oma-git/SwimForce/pictures/IMG_0896.jpeg

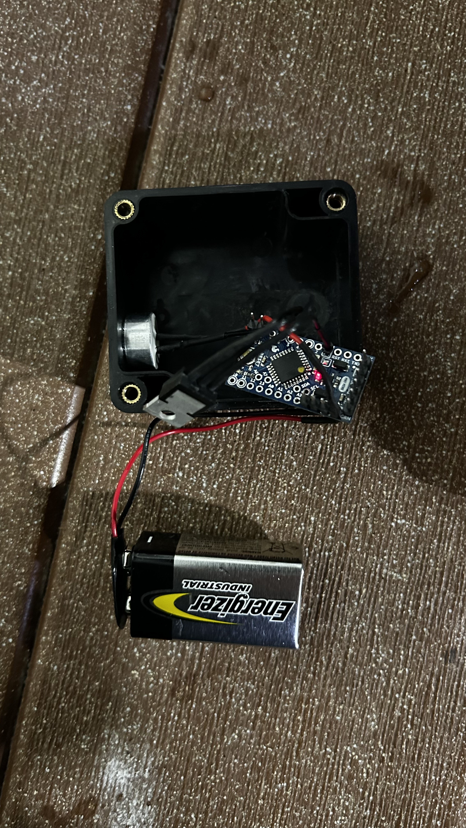
pictures/IMG_0896.jpeg
