oma-git/SwimForce/pictures/IMG_0898.jpeg

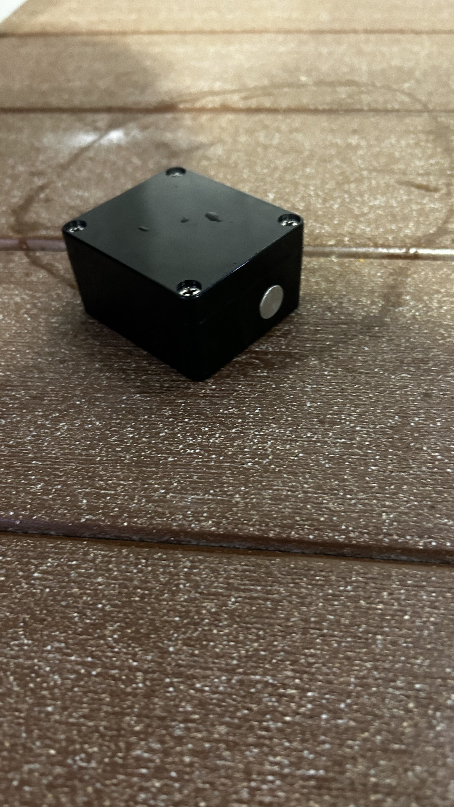
pictures/IMG_0898.jpeg
