oma-git/SwimForce/docs/SwimForce.pdf

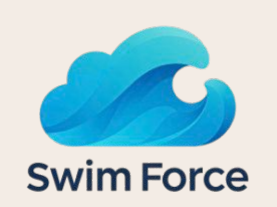
[picture p18: figure]

# A Comprehensive Swimmer Tracking System

# Cole Griscavage & Omar Ebied Professor Zucker

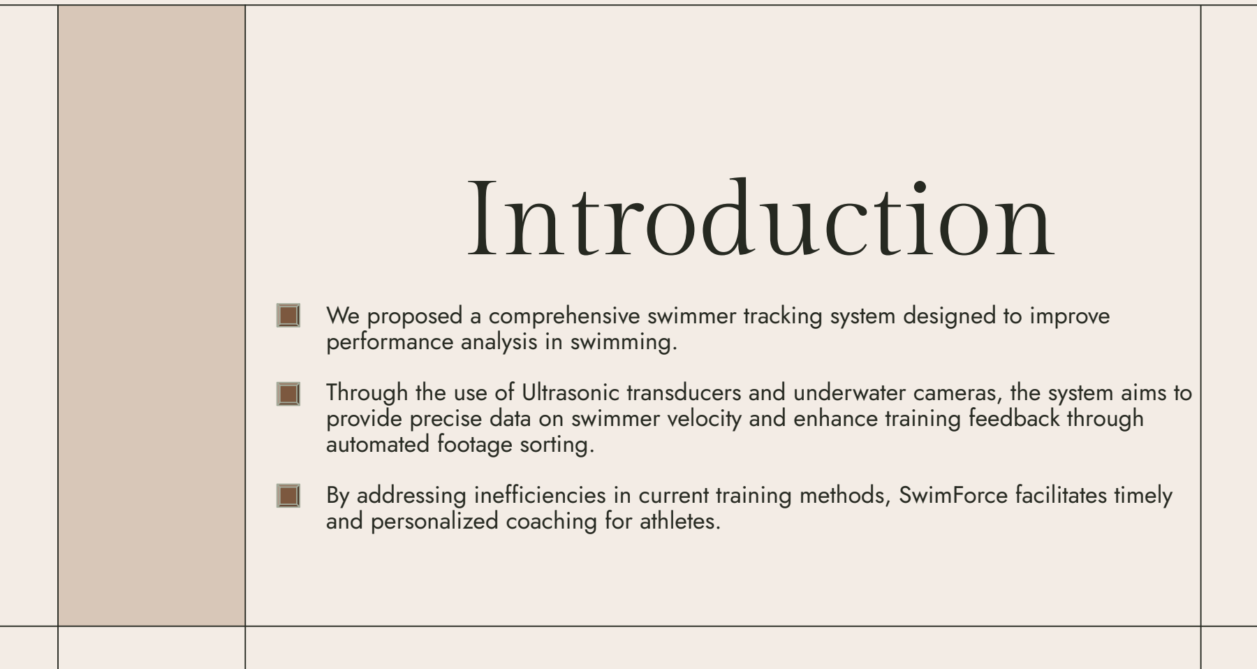
[picture p19: figure]
Introduction; performance analysis in swimming.; automated footage sorting.; and personalized coaching for athletes.

# - We proposed a comprehensive swimmer tracking system designed to improve

# - Through the use of Ultrasonic transducers and underwater cameras, the system aims to provide precise data on swimmer velocity and enhance training feedback through

# - By addressing inefficiencies in current training methods, SwimForce facilitates timely

# Goals & Overview

01

# Build ultrasonic transducer to emit customizable frequencies

# Waterproof the device & test with hydrophone in pool environment

# Use PoE cameras to capture clear footage look up from the bottom of the pool

# Write program to use hydrophone data to detect when a swimmer comes in range

# Edit program to sync camera input with hydrophone input to capture clips

# Use OpenCV to calculate swimmer velocity in acquired clips

# Edit program to collect and sort clips & data by athlete name

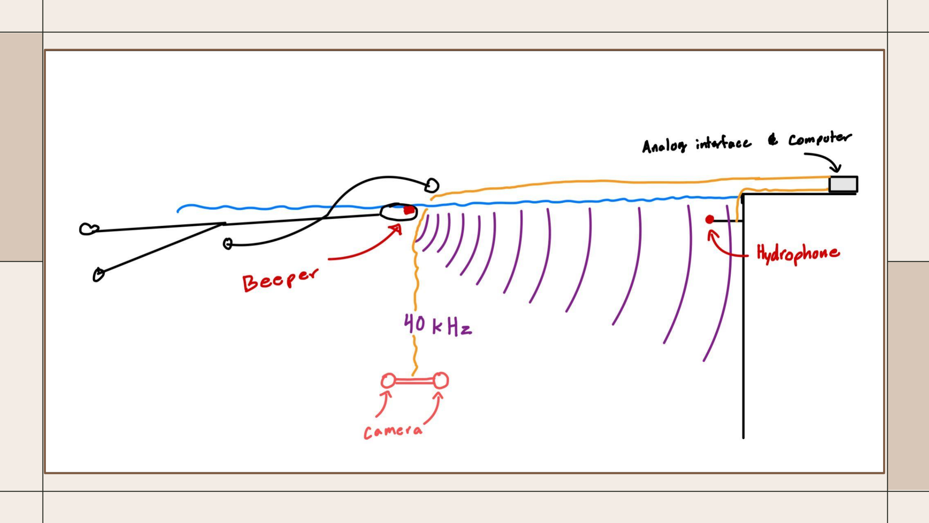
[picture p20: page 5]

# Build ultrasonic transducer to emit customizable frequencies

# Waterproof the device & test with hydrophone in pool environment

# Use PoE cameras to capture clear footage look up from the bottom of the pool

# Write program to use hydrophone data to detect when a swimmer comes in range

# Edit program to sync camera input with hydrophone input to capture clips

# Use OpenCV to calculate swimmer velocity in acquired clips

# Edit program to collect and sort clips & data by athlete name

# Timeline

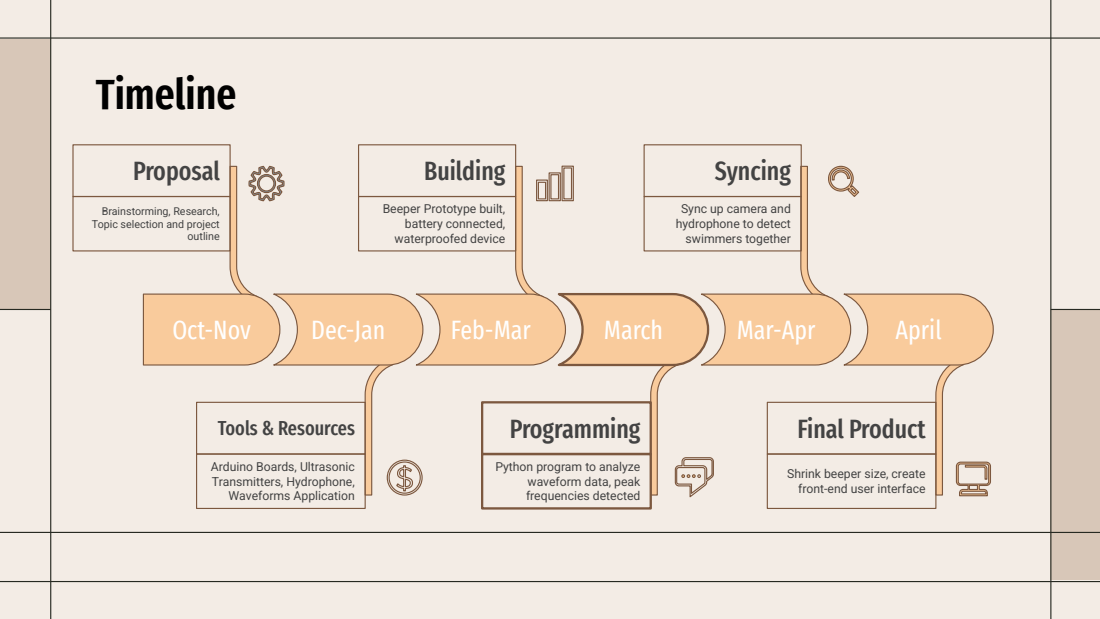
[picture p21: page 7]
Feb-Mar; Building; Mar-Apr; Syncing; Dec-Jan; Tools & Resources; March; Programming; April; Final Product; Oct-Nov; outline; Proposal

Brainstorming, Research,
Topic selection and project

Beeper Prototype built,
battery connected,
waterproofed device

Sync up camera and
hydrophone to detect
swimmers together

Arduino Boards, Ultrasonic
Transmitters, Hydrophone,
Waveforms Application

Python program to analyze
waveform data, peak
frequencies detected

Shrink beeper size, create
front-end user interface

# Technical Aspects

02

# Programming Techniques

# Python program to import the Analog Discovery 2 waveforms framework and collect audio through the hydrophone

## import numpy as np import time import ctypes import matplotlib.pyplot as plt from scipy.signal import butter, lfilter

## === Load WaveForms SDK === dwf = ctypes.CDLL("/Library/Frameworks/dwf.framework/dwf")

## # === Parameters ===

SAMPLE_RATE = 250_000 | # 200 kHz
BUFFER_SIZE = 16384 | # Match WaveForms settings
PULSE_DURATION = 10 | # Monitor for 10 seconds
ORDER = 4 | # Order of the bandpass filter
LOG_INTERVAL = 0.01 | # Log data every 0.01 seconds
THRESHOLD_DBV = -70 | # Threshold for logging timestamps

## Frequency ranges per person PEOPLE = {

# "cami": (19000, 21000),

# "omar": (20100, 20300),

"cole": (99000, 101000),
# "ham": (49000, 51000),

}

## Track threshold crossings swim_ins = {name: 0 for name in PEOPLE} last_crossed = {name: False for name in PEOPLE}

## === Store data === timestamp_dbv_data = {name: [] for name in PEOPLE} thresh_crossings = {name: [] for name in PEOPLE}

... # Device Initialization ...

# === Main Loop ===

hdwf = open_device()
if hdwf:
configure_device(hdwf)
start_time = time.time()
last_log_time = start_time
collecting = True

while time.time() - start_time < PULSE_DURATION:
current_time = time.time()

if collecting and current_time - last_log_time >= LOG_INTERVAL: last_log_time = current_time
collecting = False
elif not collecting and current_time - last_log_time >= LOG_INTERVAL: last_log_time = current_time
collecting = True

if collecting:
data = read_data(hdwf)

for name, (low, high) in PEOPLE.items():
filtered_data = butter_bandpass_filter(data, low, high, SAMPLE_RATE, order=ORDER)

# Apply windowing and FFT

window = np.blackman(len(filtered_data))
windowed = filtered_data * window
correction_factor = np.sum(window) / len(filtered_data)
fft_result = np.fft.rfft(windowed) / (BUFFER_SIZE * correction_factor) magnitudes = 20 * np.log10(np.abs(fft_result) + 1e-12)

freqs = np.fft.rfftfreq(len(filtered_data), 1 / SAMPLE_RATE) target_idx = np.where((freqs >= low) & (freqs <= high))[0]

if len(target_idx) > 0:
peak_dbv = np.max(magnitudes[target_idx])
timestamp = current_time - start_time timestamp_dbv_data[name].append((timestamp, peak_dbv))

if peak_dbv > THRESHOLD_DBV:
# Check for new threshold crossing

if not last_crossed[name]:
swim_ins[name] += 1
last_crossed[name] = True
print(f"{name} swam in at {timestamp:.2f} sec") thresh_crossings[name].append(timestamp) else:
last_crossed[name] = False
close_device(hdwf)

# - Main loop containing FFT calculations to create spectrum from audio data

# - Initialized, configured, and read data from Analog Discovery 2 prior to main loop

# - Defined bandpass filter to hone in on specified frequencies

# - Main loop collects data in intervals to reduce irrelevant data being read

# - Use windowing before performing the FFT

to improve accuracy of frequency analysis.

# - Could get the dwf FFT analysis to work properly, had to resort to numpy

# - Check for threshold crossing to detect if a swimmer came in range

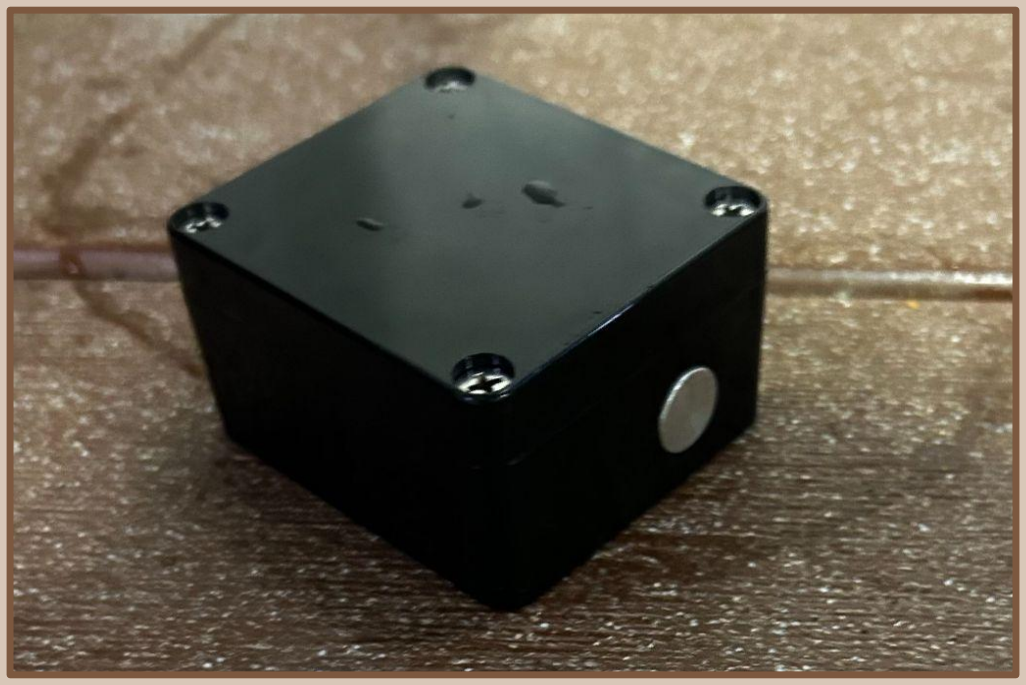
[picture p22: figure]

# The Beeper

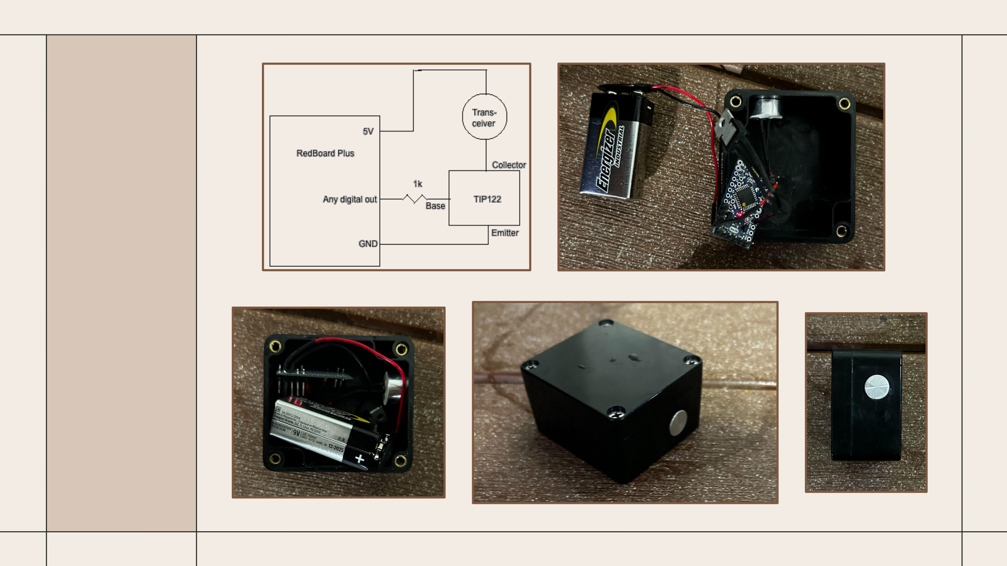
[picture p23: page 12]

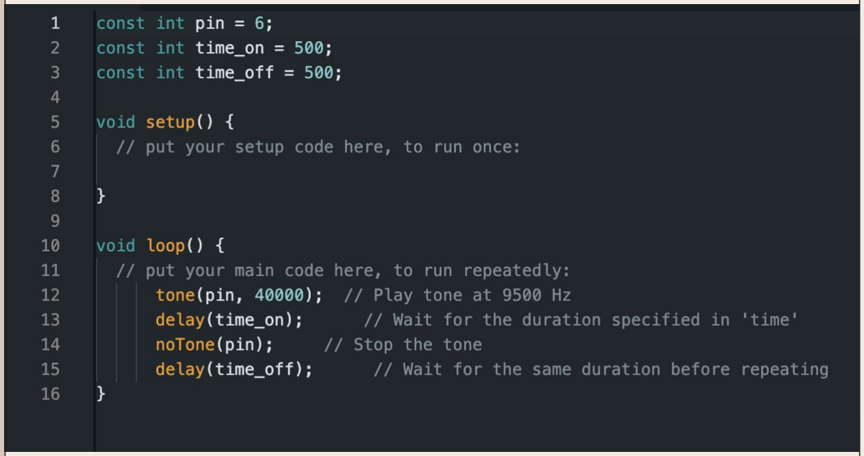
[picture p24: figure]
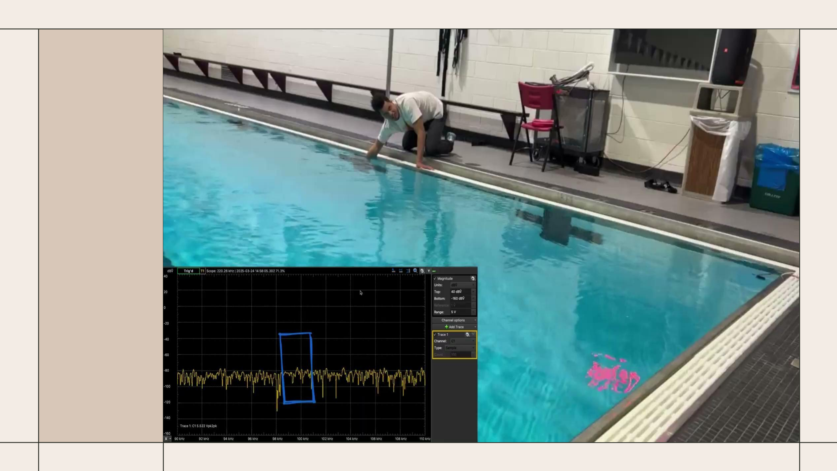
[picture p25: page 14]
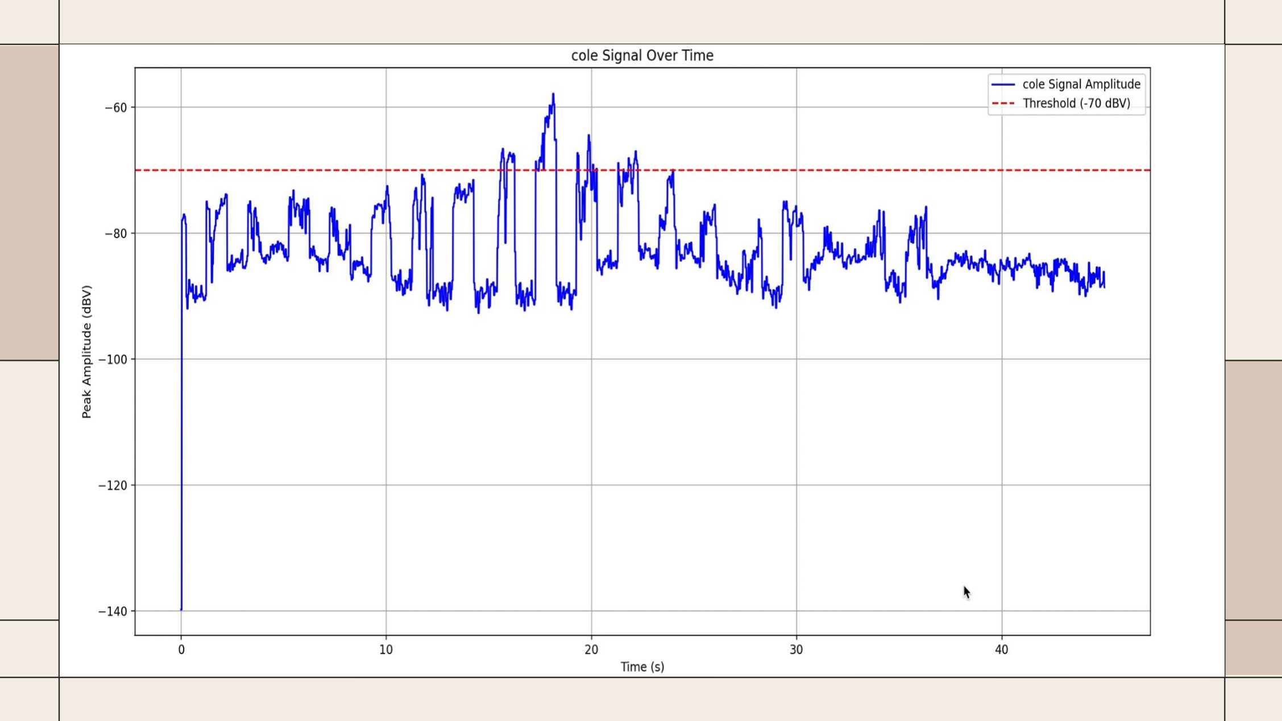
[picture p26: page 15]
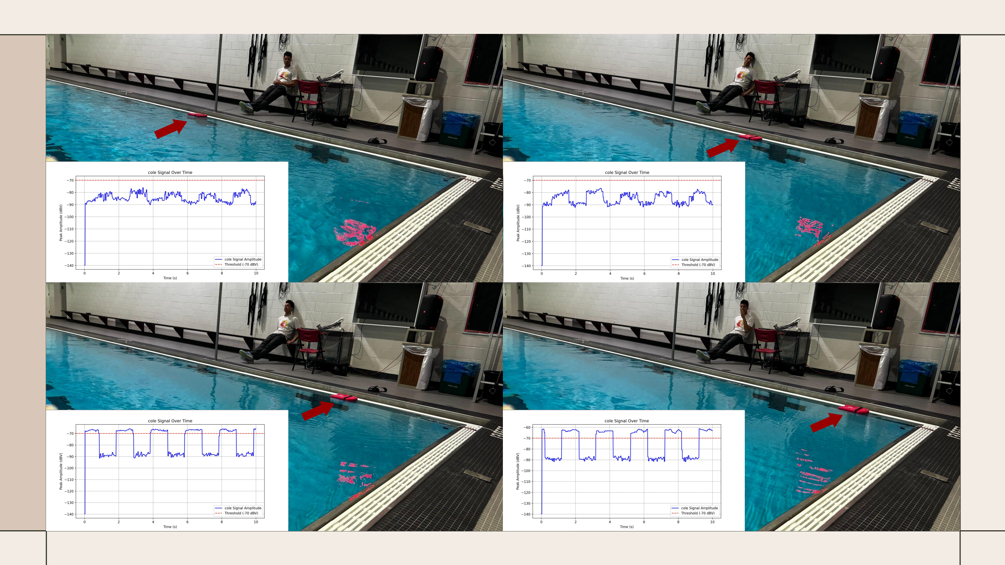
[picture p27: page 16]

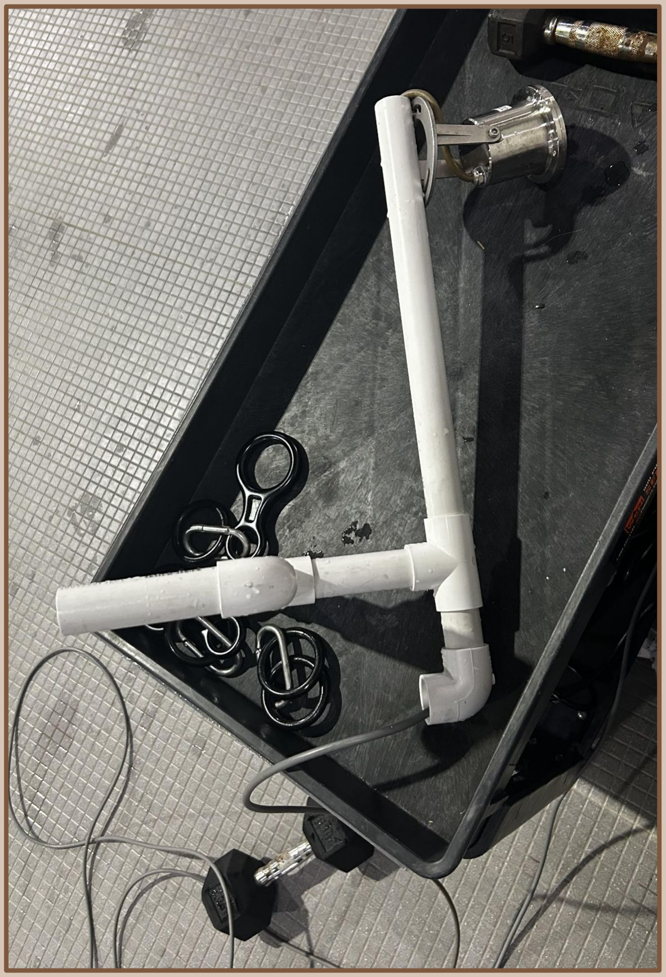
[picture p28: figure]

# Video Footage / Object Tracking

# Dual camera footage

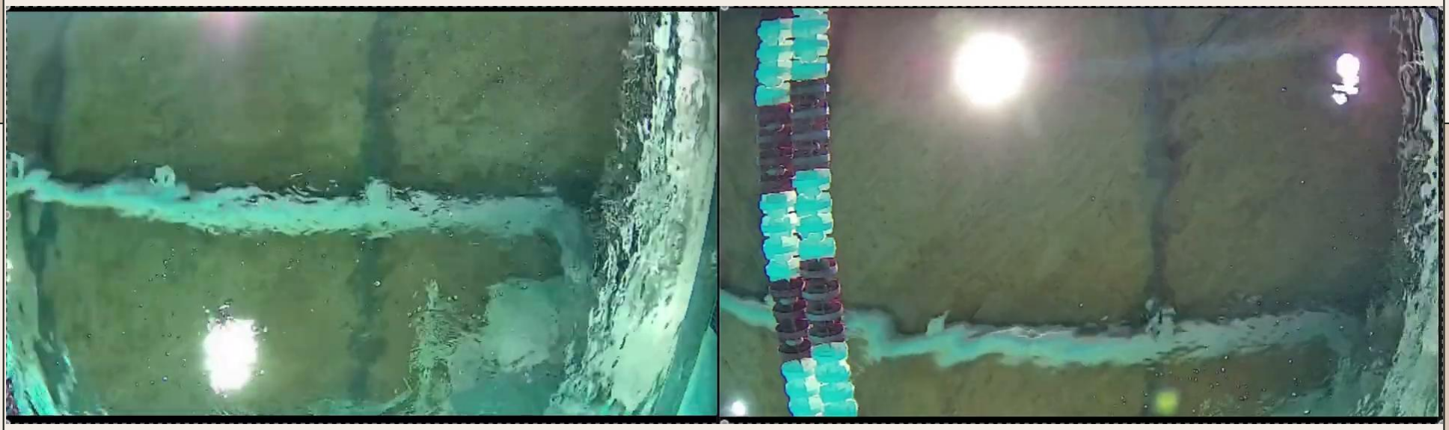
[picture p29: figure]

# Next Steps

# Build ultrasonic transducer to emit customizable frequencies

# Waterproof the device & test with hydrophone in pool environment

# Use PoE cameras to capture clear footage look up from the bottom of the pool

# Write program to use hydrophone data to detect when a swimmer comes in range

# Edit program to sync camera input with hydrophone input to capture clips

# Use OpenCV to calculate swimmer velocity in acquired clips

# Edit program to collect and sort clips & data by athlete name

# Thank You!

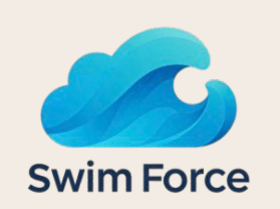
[picture p30: figure]
