oma-git/SwimForce/pictures/circuit.png

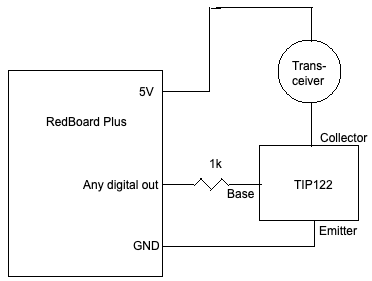
pictures/circuit.png
