oma-git/SwimForce/pictures/IMG_0894.jpeg

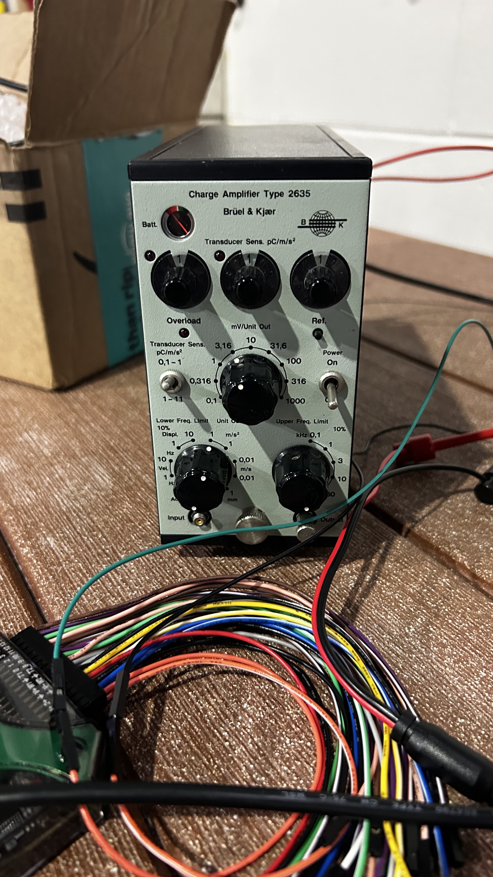
pictures/IMG_0894.jpeg
