oma-git/SwimForce/pictures/IMG_0895.jpeg

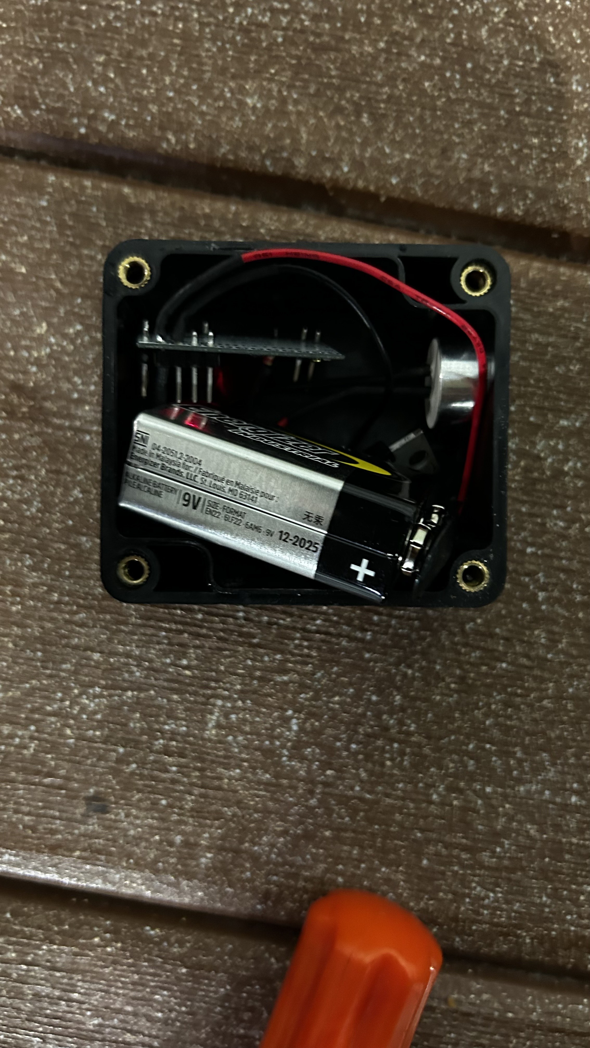
pictures/IMG_0895.jpeg
