oma-git/SwimForce/pictures/IMG_0897.jpeg

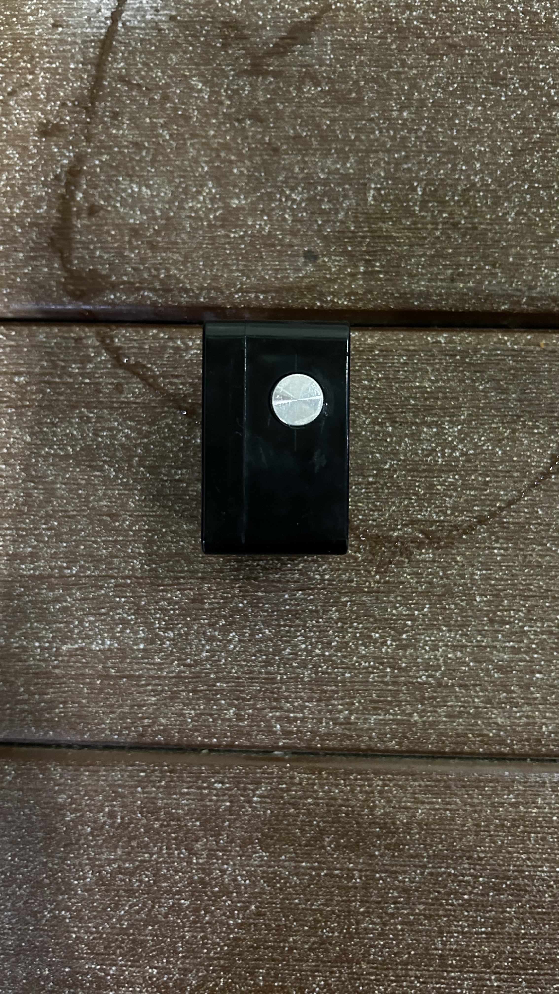
pictures/IMG_0897.jpeg
